smart-facility/cognicity-floodsensor/iot/README.md

This is code if you want to use the AWS CLI to set up sensors and rules; unless you have a large number of sensors that you want to automate the setup of I recommend use of the web console.
