smart-facility/cognicity-floodsensor/(threads)

Thread 2 (2016-10-18):

Triggered filter throws error

matthewberryman, 2016-10-18:
TypeError: Cannot read property 'end' of undefined
at exports.handler (/var/task/index.js:50:13)

Closed 2016-10-18.
