smart-facility/cognicity-floodsensor/(commit log)

2016-03-03 Fix root CA path in device.js
2016-03-03 More AWS IoT glue plus updated .gitignore
2016-03-09 Include aws-iot-device-sdk as a dependency
2016-03-09 Additional device config
2016-03-09 Modified: device.js * Fixed path prefix to be under cwd. * Fixed extension on caPath * Removed endpoint details (not needed)
2016-03-09 First cut at including sensor
2016-03-09 tidy up of device.js
2016-03-09 Flag things that need calibration
2016-03-09 Additional comment on work to be done in device.js
2016-03-12 remove unused Python sensor code
2016-03-14 For testing the sensor.
2016-06-16 prototyping database measurement insert
2016-06-17 code for DHT22 sensor + writing via lambda to pg
2016-06-20 Refactor
    Split AWS IOT, lambda, and device code out.
2016-06-20 pm2 startup processes.json for device
2016-06-20 Sample config for lambda
2016-06-20 Reflect additional sensors in README.md
2016-06-22 added sample SQL to insert sensor metadata
2016-06-29 added pg datatypes for sensor data api
2016-07-04 added computed depth to sensor_data type
2016-07-11 Change config defaults for device
2016-07-15 Ignore set of awsCert folders
    One per device so you can revoke for individual sensors once deployed.
2016-07-15 Revise AWS client ID
    To match what we have set up in AWS as device names
2016-08-04 ultrasound sensor timeout is in µs
2016-08-05 Include circuit schematic
2016-08-05 drafted schematic for Pi HAT
    [flood-hat.kicad_pcb, flood-hat.sch]
2016-08-10 Change sensor interval to 60s.
    Seems to resolve a few software and hardware oddities—not sure what these are just yet, still yet to debug the first sensor retrieved back from the canal.
2016-08-16 modified schematic to include STM32 for power control.
    [flood-hat.sch, micro.sch, optionrom.sch, powercontrol.sch, sensors.sch]
2016-08-16 removed partial print of schematic
2016-08-16 added missing net labels BOOT0 and NRST
    [micro.sch]
2016-08-16 allow STM32 to control option-ROM WP pin.
    [flood-hat.sch, micro.sch, optionrom.sch]
2016-08-18 added SPI flash and connections for STM32 to control the sensors
    [flood-hat.sch, micro.sch, optionrom.sch, powercontrol.sch, sensors.sch]
2016-10-10 swapped SPI flash for a breakout header.
    [micro.sch]
2016-10-10 imported test-code for STM32F030 that reads sensors and will do power management
2016-10-11 Add some basic data filtering to lambda function
2016-10-11 filters and batches observations for later download.
2016-10-12 power-saving: use HSI, use sleep, disable PLL while idle (serial will fail while idle)
    [Timer.cpp, Timer.h, main.cpp]
2016-10-17 added power-up when observations diverge past a threshold
2016-10-17 DUMP output now timestamped in milliseconds
2016-10-17 added README for micro. Fixed bad truncation of ms in TIME command.
    [flood.cpp]
2016-10-20 put kicad backups in gitignore
2016-10-20 draft component placement for PCB
    [flood-hat.kicad_pcb, micro.sch, powercontrol.sch]
2016-10-20 draft PCB layout; still ugly.
    [flood-hat.kicad_pcb, micro.sch]
2016-10-20 minor PCB beautifying
    [flood-hat.kicad_pcb]
2016-10-21 PCB simplification
    [flood-hat.kicad_pcb, flood-hat.sch, micro.sch, sensors.sch]
2016-10-21 PCB beautifying - cleanup silkscreen
    [flood-hat.kicad_pcb]
2016-10-21 completed PCB layout first good draft
    [flood-hat.kicad_pcb, flood-hat.sch, powercontrol.sch, sensors.sch]
2016-10-21 added gerbers
    [flood-hat-B.Cu.gbl, flood-hat-B.Mask.gbs, flood-hat-B.SilkS.gbo, flood-hat-Edge.Cuts.gm1, flood-hat-F.Cu.gtl, flood-hat-F.Mask.gts, flood-hat-F.Paste.gtp, flood-hat-F.SilkS.gto]
2016-10-21 PCB tweak U5 clearance
    [flood-hat-B.Cu.gbl, flood-hat-B.Mask.gbs, flood-hat-B.SilkS.gbo, flood-hat-Edge.Cuts.gm1, flood-hat-F.Cu.gtl, flood-hat-F.Mask.gts, flood-hat-F.Paste.gtp, flood-hat-F.SilkS.gto]
2016-10-21 fixed backwards-labels on PA4-7 breakout port
    [flood-hat-B.Cu.gbl, flood-hat-B.Mask.gbs, flood-hat-B.SilkS.gbo, flood-hat-Edge.Cuts.gm1, flood-hat-F.Cu.gtl, flood-hat-F.Mask.gts, flood-hat-F.Paste.gtp, flood-hat-F.SilkS.gto]
2016-10-22 added fiducials
    [flood-hat-B.Cu.gbl, flood-hat-B.Mask.gbs, flood-hat-B.SilkS.gbo, flood-hat-Edge.Cuts.gm1, flood-hat-F.Cu.gtl, flood-hat-F.Mask.gts, flood-hat-F.Paste.gtp, flood-hat-F.SilkS.gto]
2016-10-25 updated PCB text and edge-routing
    [flood-hat-B.Cu.gbl, flood-hat-B.Mask.gbs, flood-hat-B.SilkS.gbo, flood-hat-Edge.Cuts.gm1, flood-hat-F.Cu.gtl, flood-hat-F.Mask.gts, flood-hat-F.Paste.gtp, flood-hat-F.SilkS.gto]
2017-05-10 use newer usonic package in device.js
